shawnsony07/Halo-Non-contact-edge-mmWave-fall-detector-for-elder-care/(commit log)

2026-08-22 Refactor project structure and add technical documentation
    [Areeb_back_1.csv, Areeb_back_2.csv, Areeb_back_3.csv, Areeb_back_4.csv, Areeb_back_5.csv, Areeb_bow_1.csv, Areeb_bow_2.csv, Areeb_bow_3.csv]
2026-08-22 Include comprehensive hardware setup, wiring, and tensor specifics in README
2026-08-22 Clarify IWR6843ISK is mounted on MMWAVEICBOOST for UART connectivity
2026-08-22 docs: add Home Assistant & Mosquitto integration section, update repo tree and Thread 4 description
2026-08-22 feat: MQTT continuous streams for HA sensors, new topics, paho V2 API, sketch formatting; fix requirements index-url
    [sketch.ino]
2026-08-22 Fix MQTT sensor topics for heart rate, breath rate, fall probability
2026-08-22 config: update homeassistant mqtt sensors for raw topic values
2026-08-23 docs: use combined IWR-on-ICBOOST image in hardware section, move ICBOOST image to wiring section
2026-08-23 docs: comprehensive README rewrite - technical accuracy, thread thresholds, TLV table, CNN architecture, wiring table, corrected claims
2026-08-23 docs: clarify fall_model.pth path is relative to Arduino App Lab project root python/ subfolder
2026-08-23 docs: add STM32-MPU USB bridge comms table, Arduino App Lab section with screenshot, standalone as fallback
2026-08-23 docs: add UNO Q dual-processor spec table, correct RouterBridge to internal UART (not USB CDC), add references section with all doc links
2026-08-23 docs: rename heading to 'Radar Configuration', add UNO Q wiring diagram to MCU Setup section
2026-08-23 docs: update unoq-radar-wiring.png image
2026-08-23 docs: physically rotate wiring image 90deg clockwise to fix rendering in markdown
2026-08-23 docs: replace wiring image with correctly oriented version
2026-08-23 docs: correct wiring table to match 3-wire UNO Q setup
2026-08-23 docs: add TLV 1020 (Compressed Point Cloud) to data flow diagram
2026-08-23 docs: add MUX and SOP switch configuration images to README
2026-08-23 docs: separate SOP and MUX switch images with captions and 550px width
2026-08-23 docs: highlight SOP switch configuration with important alerts
2026-08-23 docs: add comprehensive tables for SOP and MUX switch configurations
2026-08-23 docs: add circuit wiring mermaid diagram with embedded component images
2026-08-23 docs: regenerate wiring.png with local images successfully embedded
2026-08-23 docs: use new radar image and local relative paths in wiring.mmd, regenerate wiring.png
2026-08-23 docs: regenerate wiring.png with local images successfully embedded using loose security mode
2026-08-23 docs: use Base64 image encoding to properly embed component images in wiring.png
2026-08-23 docs: increase maxTextSize in mermaidrc to allow rendering massive Base64 strings for images in wiring.png
2026-08-23 docs: insert mermaid wiring diagram into README
2026-08-23 docs: add 2m/15deg wall-mount deployment photos and TI visualizer screenshot; remove all desk/table-mount references from README
2026-08-23 feat: update sensorPosition to 2m/15deg wall-mount in sketch.ino; clean up loose root images
    [sketch.ino]
2026-08-23 docs: full README audit — fix heading emoji, clarify sensorPosition table, fix trailing space, expand repo structure
